UNIT-Electronics-MX/unit_devlab_i2s_ics_43434_mems_microphone/README.md

# DevLab: I2S ICS-43434 MEMS Microphone

The DevLab I2S ICS-43434 MEMS Microphone is a compact digital-audio module for
voice capture, acoustic sensing, and embedded audio prototypes. Its bottom-port
ICS-43434 microphone integrates signal conditioning, a 24-bit ADC, decimation
and anti-aliasing filters, power management, and an I²S interface.

<div align="center">
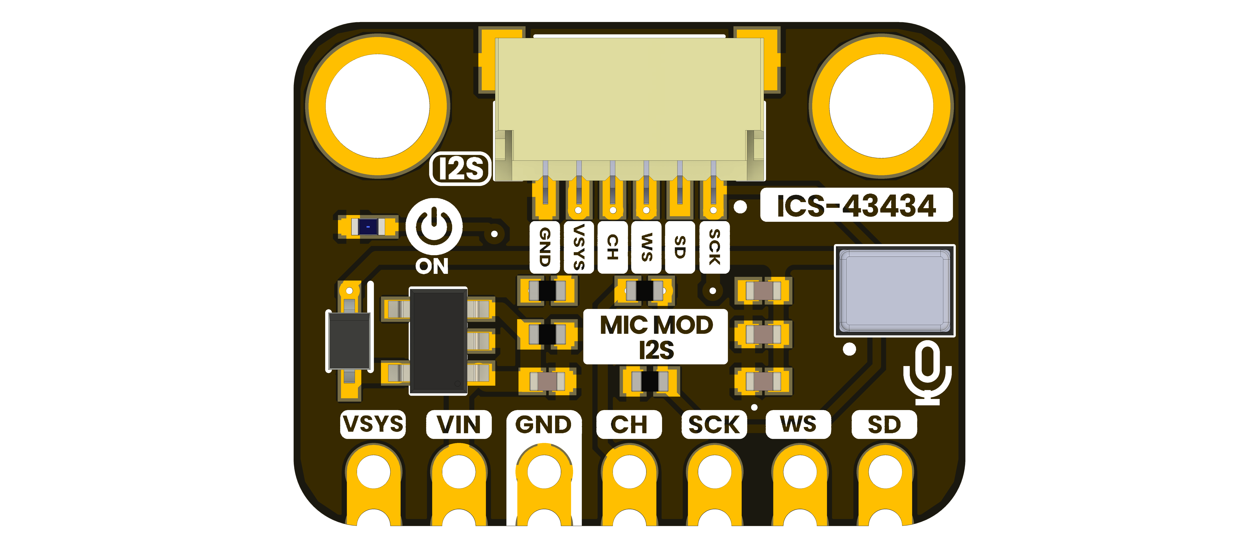
[picture p1: hardware/resources/unit_top_v_1_1_0_ue0149_devlab_i2s_ics_43434_mems_microphone_3d.png]
DevLab I2S ICS-43434 MEMS Microphone
  
  <p><em>DevLab I2S ICS-43434 MEMS Microphone</em></p>
</div>

<div align="center">

### Quick Setup

[]()
[](docs/hardware/unit_product_reference_v_0_1_0_i2s_ics43434_mems_microphone.pdf)
[]()
[](software/examples/i2s/README.md)

</div>

<div align="center">

## Overview

| Feature | Description |
|---|---|
| Product | DevLab I2S ICS-43434 MEMS Microphone |
| MPN | UE0149 |
| Microphone | InvenSense ICS-43434 bottom-port MEMS microphone |
| Module Input Voltage | Pending board-level validation; sensor VDD is 1.65–3.63 V |
| Sleep Mode Current | 12 uA |
| Sensitivity | -26 dB FS |
| Directionality | Omni |
| SNR | 64 dBA |
| Dynamic Range| 90 dB |
| Frequency Response | 60 Hz - 20 KHz |
| PSR | -98 dB FS |
| THD | 0.2 % |
| Hardware Revision | V1.0 |
| Audio Interface | I²S digital output |
| Sample Width | 24 bit |
| Channel Selection | `CH` input and `L/R` solder selection |
| Microphone Supply | 1.65 V to 3.63 V at the ICS-43434 VDD pin |
| Onboard Regulation | AP2112K fixed 3.3 V LDO |
| Connections | Seven 2.54 mm edge connections and 6-pin JST-SH connector |

</div>

## Applications

- **Voice Capture:** Digital audio acquisition for speech and voice interfaces.
- **Acoustic Sensing:** Sound-level and event-detection prototypes.
- **Communication:** Intercom and teleconferencing experiments.
- **Microphone Arrays:** Left/right channel selection for multi-microphone tests.
- **Education:** I²S audio acquisition and embedded-systems learning.

## Resources

- [Schematic Diagram](<hardware/unit_sch_v_1_1_0_ue0149_devlab_ i2s_ics_43434_mems_microphone.pdf>)
- [Pinout Diagram](https://github.com/UNIT-Electronics-MX/unit_devlab_i2s_ics_43434_mems_microphone/blob/main/hardware/README.md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)
- [Arduino library example](software/examples/i2s/cpp_examples/AudioInputBasicRead/AudioInputBasicRead.ino)
- [Software example instructions](software/examples/README.md)
- [Legacy I²S driver example](software/examples/i2s/cpp_examples/LegacySerialPlotter/LegacySerialPlotter.ino)

## 📝 License

All hardware and documentation in this project are licensed under the **MIT
License**. See the [repository license](https://github.com/UNIT-Electronics-MX/unit_devlab_i2s_ics_43434_mems_microphone/blob/main/LICENSE)
for details. Third-party reference files may have separate terms.
