UNIT-Electronics-MX/unit_devlab_i2s_ics_43434_mems_microphone/hardware/README.md

# DevLab I2S ICS-43434 MEMS Microphone Hardware

## Hardware Scope

This page documents **DevLab I2S ICS-43434 MEMS Microphone** from the V1.1.0 board views, pinout, schematic, and available component records. Component ratings do not define the complete module input limits.

| Field | Value |
|---|---|
| MPN | UE0149 |

## Power Tree

The BOM identifies `U3` as an AP2112K fixed 3.3 V regulator in the microphone power section. The permitted module-level `VIN` and `VSYS` ranges require board validation; a dedicated power-tree drawing is not available.

## Block Diagram

UE0149 I²S ICS-43434 functional block diagram

The host supplies `SCK` and `WS`; the microphone sends audio on
`SD`. The diagram also shows channel control and the board power section.

## Naming Rules

- Product name: **DevLab I2S ICS-43434 MEMS Microphone**.
- Product family: **UNIT DevLab ecosystem**.
- Existing source files retain their published names and revisions.
- Generated Product Reference: `unit_product_reference_v_0_1_0_i2s_ics43434_mems_microphone.pdf`.

## Hardware

The DevLab I2S ICS-43434 MEMS Microphone is a compact digital-audio module
based on the bottom-port ICS-43434 microphone. The board views correspond to
hardware V1.0.

<div align="center">
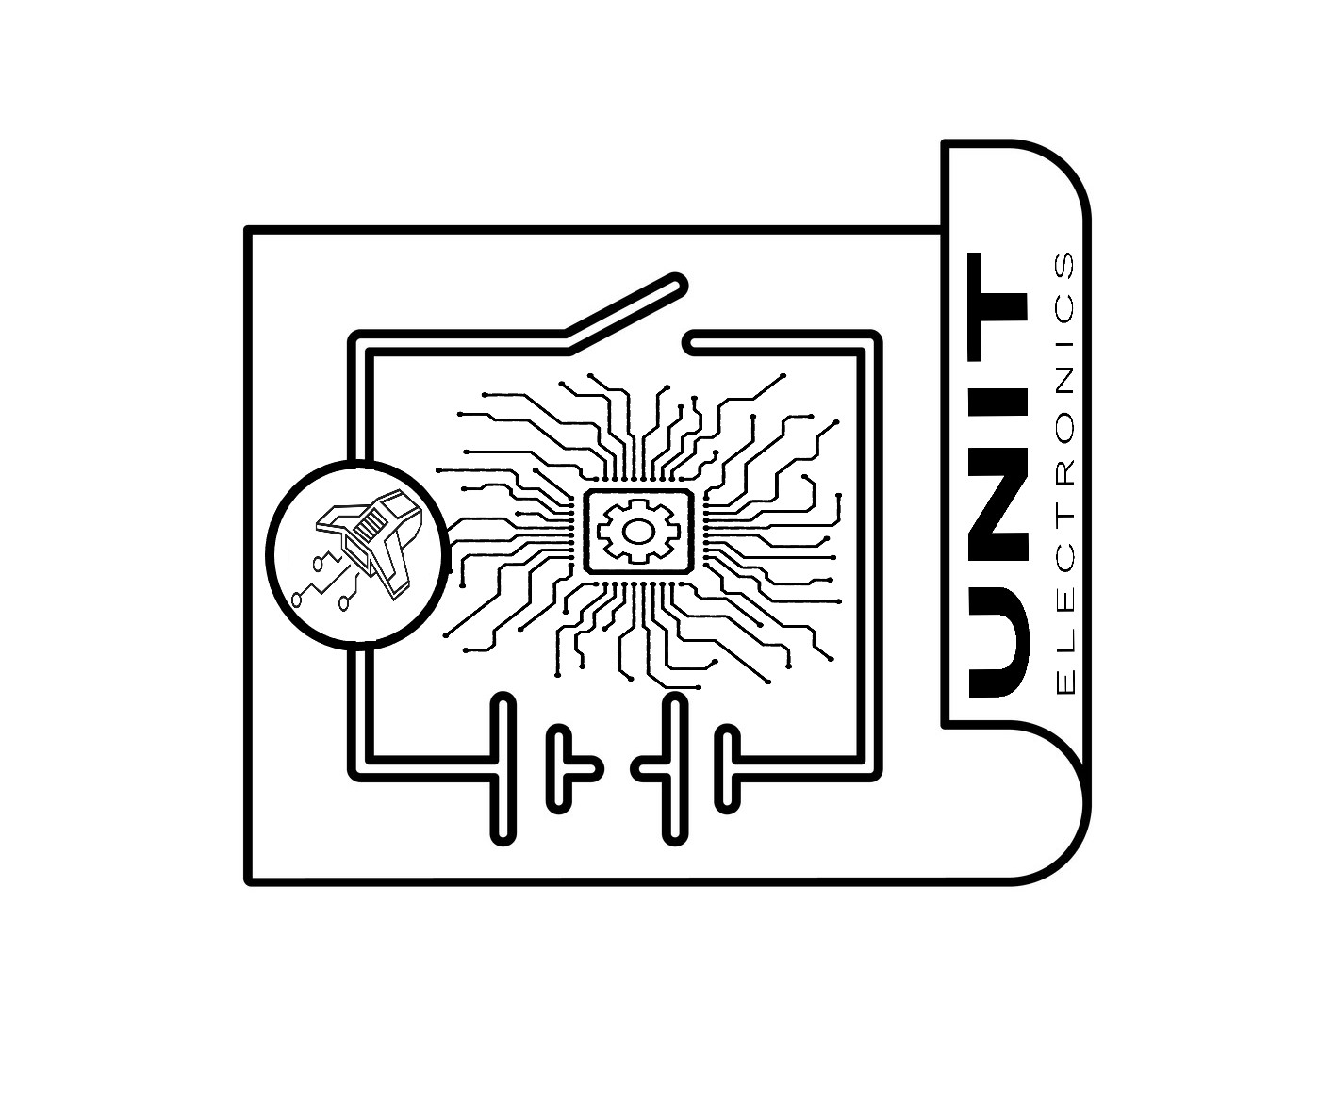
[picture p2: hardware/resources/Schematics_icon.jpg]
Schematic
<br/>
<a href="./unit_sch_v_1_1_0_ue0149_devlab_ i2s_ics_43434_mems_microphone.pdf">Schematic</a>
</div>

UE0149 I2S ICS-43434 top view

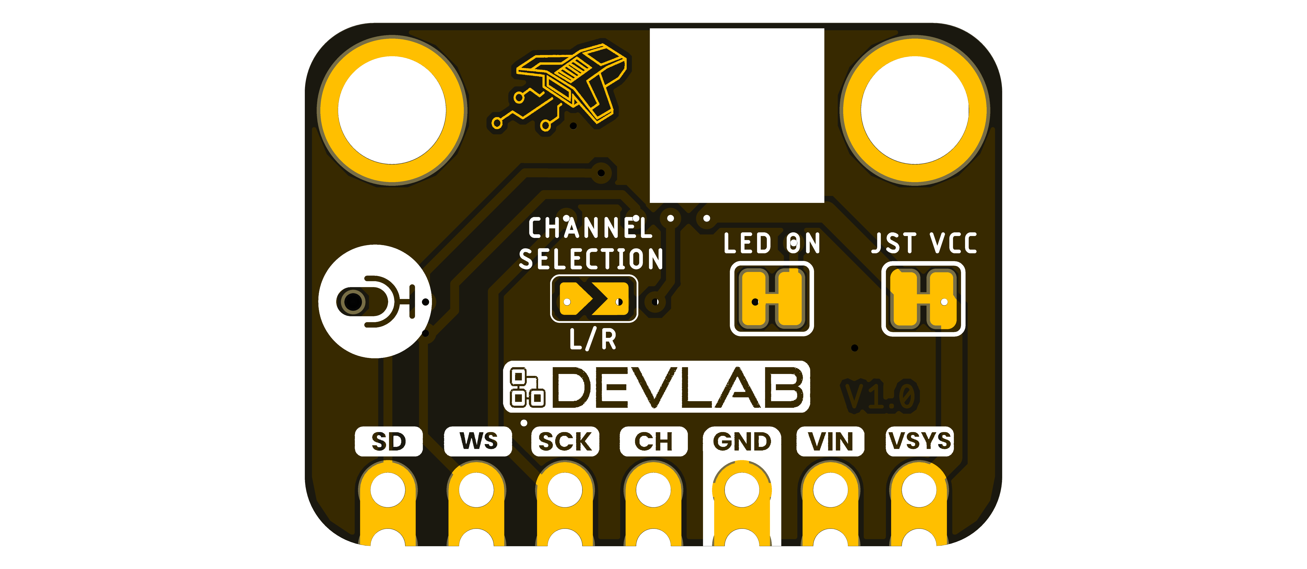
[picture p3: hardware/resources/unit_btm_v_1_1_0_ue0149_devlab_i2s_ics_43434_mems_microphone_3d.png]
UE0149 I2S ICS-43434 bottom view


## Pinout

<div align="center">
<a href="./unit_pinout_v_1_1_0_ue0149_devlab_ i2s_ics_43434_mems_microphone_en.pdf">
<br/>
Pinout
</a>
</div>

| Pin Label | Direction | Function | Notes |
|---|---|---|---|
| `VIN` | Input | Module input supply | Module-level range pending validation |
| `VSYS` | Power | Module system rail | 3.3 V |
| `GND` | Power | Common reference | 0 V |
| `CH` | Input | I²S channel selection | Low selects left; high selects right; schematic default is left |
| `SCK` | Input | I²S serial bit clock | Driven by the host |
| `WS` | Input | I²S word select | Low is left word; high is right word |
| `SD` | Output | I²S serial audio data | 24-bit microphone output |

## Dimensions

<div align="center">
<a href="./resources/unit_dimensions_v_1_1_0_ue0149_devlab_ i2s_ics_43434_mems_microphone.png">
<br/>
Dimensions
</a>
</div>

## Topology

<div align="center">
<a href="./resources/unit_topology_v_1_1_0_ue0149_devlab_ i2s_ics_43434_mems_microphone.png">
<br/>
Topology
</a>
</div>

| Ref. | Description |
|---|---|
| MK1 | ICS-43434 bottom-port digital MEMS microphone |
| U3 | AP2112K-3.3 fixed 3.3 V LDO regulator |
| D1 | Orange power indicator LED |
| D2 | NSR0320MW2T1G Schottky diode |
| J1 | 6-position JST-SH connector, 1.0 mm pitch |
| U$1 | Seven 2.54 mm edge connections |
| `L/R` | Channel-selection solder option |
| `LED ON` | Indicator solder option; behavior pending schematic verification |
| `JST VCC` | Connector-supply solder option; behavior pending schematic verification |

## Pin & Connector Layout

The seven edge connections expose `VSYS`, `VIN`, `GND`, `CH`, `SCK`, `WS`, and
`SD`. The six-position JST-SH connector exposes `GND`, `VSYS`, `CH`, `WS`, `SD`,
and `SCK`; `VIN` is available only on the edge connection.

| Signal | Electrical Information | Function |
|---|---|---|
| `VIN` | Module range pending | Input to the onboard power section |
| `VSYS` | Range pending | System and JST supply rail |
| `GND` | 0 V | Common power and signal reference |
| `CH` | Logic level pending module validation | Selects the I²S left or right time slot |
| `SCK` | Logic level pending module validation | Serial bit clock from the host |
| `WS` | Logic level pending module validation | Word-select clock from the host |
| `SD` | Digital output | Serial audio data to the host |

> **Note:** The BOM lists a four-conductor QWIIC-style harness while J1 is a
> six-position connector. Cable inclusion and compatibility must be verified
> before connection.

## Functional Description

The host supplies the I²S clocks on `SCK` and `WS`. The ICS-43434 converts the
acoustic signal and transmits 24-bit samples on `SD` in the time slot selected
by `CH`. The AP2112K provides a nominal 3.3 V rail for the microphone circuit.

Keep the bottom acoustic port unobstructed and free of debris, adhesive, flux,
or enclosure pressure. Connect the host and module grounds before applying
power or clocks. Do not drive `SD`; it is an output from the microphone.

### Electrical Characteristics

| Parameter | Value | Scope |
|---|---:|---|
| Microphone VDD | 1.65 V to 3.63 V | ICS-43434 supply pin, DS-000069 rev. 1.2 |
| Digital output | 24 bit | ICS-43434 I²S interface |
| Signal-to-noise ratio | 65 dBA high-performance; 64 dBA low-power, typical | Microphone characteristic |
| Frequency response | 60 Hz to 20 kHz | EMMIC-ICS43434 reference |
| Sensitivity tolerance | ±1 dB | Microphone characteristic |

The microphone VDD range and individual component ratings do not establish the
permitted voltage at the module's `VIN` pin.

### BOM-Confirmed Components

| Reference | Identification |
|---|---|
| MK1 | ICS-43434 |
| U3 | AP2112K-3.3TRG1 |
| J1 | JST SM06B-SRSS-TB |
| D2 | NSR0320MW2T1G |
| C8, C9 | 1 µF, 6.3 V, X5R, 0402 |
| C6 | 100 nF, 0402 |
| C1 | 200 pF, C0G, 50 V, 0402 |
| R1 | 4.7 kΩ, 0402 |
| R2, R3 | 10 kΩ, 0402 |
| R5 | 0 Ω, 0402 |

## Applications

- Voice capture and recognition prototypes
- Acoustic sensing and sound-event detection
- Intercom and teleconferencing systems
- Stereo and multi-microphone experiments
- Educational I²S audio acquisition

## References

- [EMMIC-ICS43434 Reference](https://github.com/UNIT-Electronics-MX/unit_devlab_i2s_ics_43434_mems_microphone/blob/main/hardware/resources/external/emmic-ics43434-ds.pdf)
- [Manufacturer ICS-43434 datasheet](resources/external/DS-000069-ICS-43434-v1.2.pdf)
- [DevLab_AudioInput example](../software/examples/i2s/cpp_examples/AudioInputBasicRead/AudioInputBasicRead.ino)
- [Manufacturing BOM](https://github.com/UNIT-Electronics-MX/unit_devlab_i2s_ics_43434_mems_microphone/blob/main/hardware/resources/UNIT-0149%20Devlab_%20I2S%20ICS-43434%20MEMS%20Micropho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)
- [Legacy I²S Example](https://github.com/UNIT-Electronics-MX/unit_devlab_i2s_ics_43434_mems_microphone/blob/main/software/examples/i2s/cpp_examples/LegacySerialPlotter/LegacySerialPlotter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)
- [Product Reference](../docs/hardware/unit_product_reference_v_0_1_0_i2s_ics43434_mems_microphone.pdf)
