UNIT-Electronics-MX/unit_devlab_i2s_ics_43434_mems_microphone/software/README.md

# UE0149 Software

See [Software Examples](examples/README.md) for the ESP32-S3
`DevLab_AudioInput` sketch, channel selection, and wiring notes.
The complete board procedure is in
[Board Operation](../tools/product-reference/chapters/05-board-operation.md).
