UNIT-Electronics-MX/unit_devlab_i2s_ics_43434_mems_microphone/tools/product-reference/chapters/06-mechanical.md

## **6 Mechanical Information**

### **6.1 Top View** {.section-page}

UE0149 I2S microphone top view.

### **6.2 Bottom View** {.section-page}

UE0149 I2S microphone bottom view.

The bottom acoustic port remains clear of adhesive, contamination, and mounting hardware.

### **6.3 Board Dimensions** {.section-page}

The [dimension drawing](https://github.com/UNIT-Electronics-MX/unit_devlab_i2s_ics_43434_mems_microphone/blob/main/hardware/resources/unit_dimensions_v_1_1_0_ue0149_devlab_%20i2s_ics_43434_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)
is stored with the board images.

The labeled drawing provides the board dimensions for mechanical layout.
The physical assembly determines connector clearance and manufacturing tolerances.
