UNIT-Electronics-MX/unit_devlab_i2s_ics_43434_mems_microphone/tools/product-reference/chapters/01-board.md

## **1 The Module**

### **1.1 Board Identification**

| Item | Value |
|---|---|
| Product | DevLab: I2S ICS-43434 MEMS Microphone |
| Manufacturer part number | UE0149 |
| Hardware revision shown | V1.0 |
| Microphone | ICS-43434 |
| Digital audio interface | I²S |
| Product-reference revision | 0.1.0 |

### **1.2 Interface Hardware**

The module provides seven 2.54 mm edge connections and a six-position,
1.0 mm-pitch JST-SH connector. The connector carries `GND`, `VSYS`, `CH`,
`WS`, `SD`, and `SCK`. Its signal order follows the board pinout in Section 4.
