UNIT-Electronics-MX/unit_devlab_i2s_ics_43434_mems_microphone/tools/product-reference/chapters/08-references.md

## **8 Reference Documentation**

| Reference | Location |
|---|---|
| Repository | [UNIT-Electronics-MX/unit_devlab_i2s_ics_43434_mems_microphone](https://github.com/UNIT-Electronics-MX/unit_devlab_i2s_ics_43434_mems_microphone) |
| Hardware notes | [Hardware README](https://github.com/UNIT-Electronics-MX/unit_devlab_i2s_ics_43434_mems_microphone/blob/main/hardware/README.md) |
| Pinout PDFs | [English](https://github.com/UNIT-Electronics-MX/unit_devlab_i2s_ics_43434_mems_microphone/blob/main/hardware/unit_pinout_v_1_1_0_ue0149_devlab_%20i2s_ics_43434_mems_microphon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) · [Spanish](https://github.com/UNIT-Electronics-MX/unit_devlab_i2s_ics_43434_mems_microphone/blob/main/hardware/unit_pinout_v_1_1_0_ue0149_devlab_%20i2s_ics_43434_mems_microphon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) |
| Pinout images | [English PNG](https://github.com/UNIT-Electronics-MX/unit_devlab_i2s_ics_43434_mems_microphone/blob/main/hardware/resources/unit_pinout_v_1_1_0_ue0149_devlab_%20i2s_ics_43434_mems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) · [Spanish PNG](https://github.com/UNIT-Electronics-MX/unit_devlab_i2s_ics_43434_mems_microphone/blob/main/hardware/resources/unit_pinout_v_1_1_0_ue0149_devlab_%20i2s_ics_43434_mems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) |
| Microphone reference | [EMMIC-ICS43434 PDF](https://github.com/UNIT-Electronics-MX/unit_devlab_i2s_ics_43434_mems_microphone/blob/main/hardware/resources/external/emmic-ics43434-ds.pdf) |
| Manufacturer sensor datasheet | [DS-000069 rev. 1.2](https://github.com/UNIT-Electronics-MX/unit_devlab_i2s_ics_43434_mems_microphone/blob/main/hardware/resources/external/DS-000069-ICS-43434-v1.2.pdf) |
| Module schematic | [UE0149 schematic](https://github.com/UNIT-Electronics-MX/unit_devlab_i2s_ics_43434_mems_microphone/blob/main/hardware/unit_sch_v_1_1_0_ue0149_devlab_%20i2s_ics_43434_mems_microphone.p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) |
| Capture library | [DevLab_AudioInput](https://github.com/UNIT-Electronics-MX/unit_devlab_audioinput_library) |
| Module block diagram | [UE0149 block diagram](https://github.com/UNIT-Electronics-MX/unit_devlab_i2s_ics_43434_mems_microphone/blob/main/hardware/resources/external/i2s_ics_43434_mems_microphone.png) |
| Library-based example | [UE0149 AudioInputBasicRead](https://github.com/UNIT-Electronics-MX/unit_devlab_i2s_ics_43434_mems_microphone/blob/main/software/examples/i2s/cpp_examples/AudioInputBasicRead/AudioInputBasicRead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) |
| Experimental firmware | [Legacy I²S example](https://github.com/UNIT-Electronics-MX/unit_devlab_i2s_ics_43434_mems_microphone/blob/main/software/examples/i2s/cpp_examples/LegacySerialPlotter/LegacySerialPlotter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) |
| Top view | [3D board view](https://github.com/UNIT-Electronics-MX/unit_devlab_i2s_ics_43434_mems_microphone/blob/main/hardware/resources/unit_top_v_1_1_0_ue0149_devlab_i2s_ics_43434_mems_micro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) |
| Bottom view | [3D board view](https://github.com/UNIT-Electronics-MX/unit_devlab_i2s_ics_43434_mems_microphone/blob/main/hardware/resources/unit_btm_v_1_1_0_ue0149_devlab_i2s_ics_43434_mems_micro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) |
| CAD model | [STEP](https://github.com/UNIT-Electronics-MX/unit_devlab_i2s_ics_43434_mems_microphone/blob/main/hardware/mechanics/unit_3d_v_1_1_0_ue0149_devlab_%20i2s_ics_43434_mems_mic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) |

The manufacturer document DS-000069 revision 1.2 (2016-08-29) supplies the
sensor timing, modes, and interface characteristics. The UE0149 schematic
supplies the module circuit connections, and the board artwork supplies the
visible signal labels. The EMMIC-ICS43434 file describes a separate
breakout board.
