UNIT-Electronics-MX/unit_devlab_i2s_ics_43434_mems_microphone/tools/product-reference/chapters/00-description.md

## **Description**

The UNIT DevLab I²S ICS-43434 MEMS Microphone is a compact digital-audio module based on the
bottom-port ICS-43434 MEMS microphone. The microphone integrates signal
conditioning, a 24-bit analog-to-digital converter, decimation and
anti-aliasing filters, power management, and an I²S output.



### **Applications**

- Voice capture and recognition prototypes
- Intercom and teleconferencing systems
- Acoustic sensing and security projects
- Stereo or microphone-array experiments
- Educational I²S audio acquisition

### **Hardware Features**

- ICS-43434 bottom-port digital MEMS microphone
- 24-bit I²S serial audio output
- Left/right time-slot selection through the `CH` signal
- AP2112K fixed 3.3 V onboard regulator
- Seven 2.54 mm edge connections
- Six-position, 1.0 mm-pitch JST-SH connector
- Power indicator and selectable solder options shown on the V1.0 artwork
