UNIT-Electronics-MX/unit_devlab_i2s_ics_43434_mems_microphone/docs/hardware/index.html

UNIT Electronics · DevLab

# DevLab I2S ICS-43434 MEMS Microphone

Direct links to hardware documentation and product files for use in external platforms.

22 files 11 images 8 formats 44.1 MB total

Search hardware resources

## Product documents

3 files

DOCX 3.7 MB

### Product Reference

Editable product reference

unit_product_reference_v_0_1_0_i2s_ics43434_mems_microphone.docx

Copy link Open file

PDF 4.1 MB

### Product Reference

Publication-ready product reference

unit_product_reference_v_0_1_0_i2s_ics43434_mems_microphone.pdf

Copy link Open file

PDF 49.8 KB

### Schematic

Electrical schematic

unit_sch_v_1_1_0_ue0149_devlab_ i2s_ics_43434_mems_microphone.pdf

Copy link Open file

## Pinouts

6 files

JPG 6.5 MB

### Pinout — English

Connector and signal reference in English

resources/unit_pinout_v_1_1_0_ue0149_devlab_ i2s_ics_43434_mems_microphone_en.jpg

Copy link Open file

PDF 5.2 MB

### Pinout — English

Connector and signal reference in English

unit_pinout_v_1_1_0_ue0149_devlab_ i2s_ics_43434_mems_microphone_en.pdf

Copy link Open file

PNG 1.8 MB

### Pinout — English

Connector and signal reference in English

resources/unit_pinout_v_1_1_0_ue0149_devlab_ i2s_ics_43434_mems_microphone_en.png

Copy link Open file

JPG 6.6 MB

### Pinout — Spanish

Connector and signal reference in Spanish

resources/unit_pinout_v_1_1_0_ue0149_devlab_ i2s_ics_43434_mems_microphone_es.jpg

Copy link Open file

PDF 5.2 MB

### Pinout — Spanish

Connector and signal reference in Spanish

unit_pinout_v_1_1_0_ue0149_devlab_ i2s_ics_43434_mems_microphone_es.pdf

Copy link Open file

PNG 1.8 MB

### Pinout — Spanish

Connector and signal reference in Spanish

resources/unit_pinout_v_1_1_0_ue0149_devlab_ i2s_ics_43434_mems_microphone_es.png

Copy link Open file

## Board views

5 files

PNG 1.1 MB

### Board Topology

Functional board layout

resources/unit_topology_v_1_1_0_ue0149_devlab_ i2s_ics_43434_mems_microphone.png

Copy link Open file

PNG 1.0 MB

### Bottom View

Bottom-side board view

resources/unit_btm_v_1_1_0_ue0149_devlab_i2s_ics_43434_mems_microphone_3d.png

Copy link Open file

PNG 816.2 KB

### Mechanical Dimensions

Board outline and dimensions

resources/unit_dimensions_v_1_1_0_ue0149_devlab_ i2s_ics_43434_mems_microphone.png

Copy link Open file

PNG 1.1 MB

### Top View

Top-side board view

resources/unit_top_v_1_0_0_i2s_ics43434_mems_microphone.png

Copy link Open file

PNG 1018.2 KB

### Top View

Top-side board view

resources/unit_top_v_1_1_0_ue0149_devlab_i2s_ics_43434_mems_microphone_3d.png

Copy link Open file

## CAD and design files

1 file

STEP 1.1 MB

### 3D CAD Model

STEP mechanical model

mechanics/unit_3d_v_1_1_0_ue0149_devlab_ i2s_ics_43434_mems_microphone.step

Copy link Open file

## Other resources

7 files

FILE 41 B

### .Gitattributes

Hardware resource

mechanics/.gitattributes

Copy link Open file

PNG 32.3 KB

### Audioinput Library

Hardware resource

resources/external/audioinput_library.png

Copy link Open file

PDF 1.1 MB

### Ds 000069 Ics 43434 V1.2

Hardware resource

resources/external/DS-000069-ICS-43434-v1.2.pdf

Copy link Open file

PDF 633.4 KB

### Emmic Ics43434 Ds

Hardware resource

resources/external/emmic-ics43434-ds.pdf

Copy link Open file

MD 7.0 KB

### Hardware README

Hardware overview and source notes

README.md

Copy link Open file

PNG 145.8 KB

### I2S Ics 43434 Mems Microphone

Hardware resource

resources/external/i2s_ics_43434_mems_microphone.png

Copy link Open file

F3D 1.4 MB

### Unit 3D V 1 1 0 Ue0149 Devlab I2S Ics 43434 Mems Microphone

Hardware resource

mechanics/unit_3d_v_1_1_0_ue0149_devlab_ i2s_ics_43434_mems_microphone.f3d

Copy link Open file

No resources match your search.

UNIT Electronics hardware resources
