UNIT-Electronics-MX/unit_devlab_i2s_ics_43434_mems_microphone/hardware/resources/unit_btm_v_1_1_0_ue0149_devlab_ i2s_ics_43434_mems_microphone_2d.png

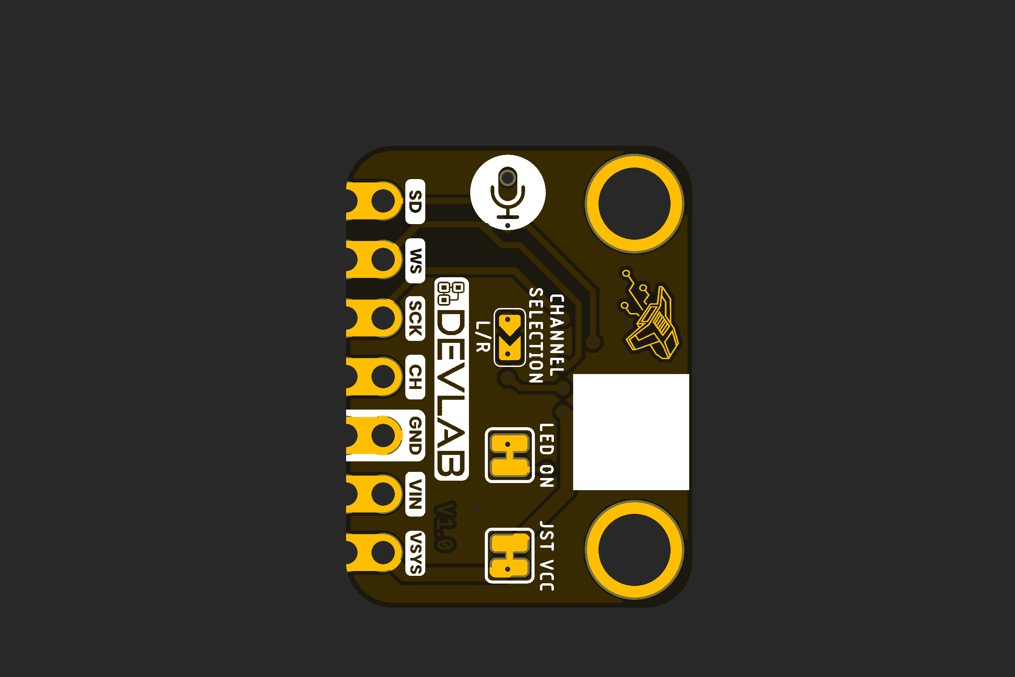
hardware/resources/unit_btm_v_1_1_0_ue0149_devlab_ i2s_ics_43434_mems_microphone_2d.png
