UNIT-Electronics-MX/unit_devlab_i2s_ics_43434_mems_microphone/hardware/mechanics/unit_3d_v_1_1_0_ue0149_devlab_ i2s_ics_43434_mems_microphone.step

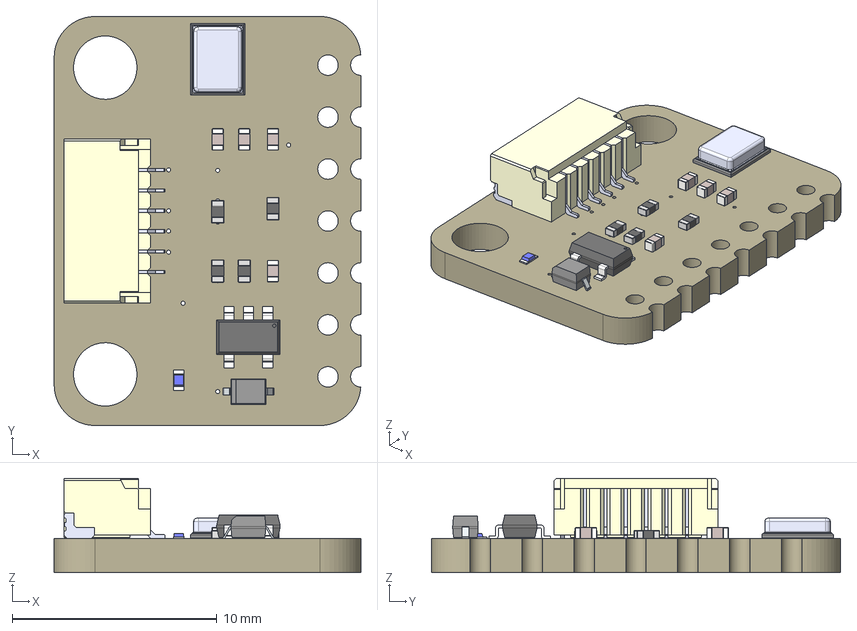
[picture p9: CAD file, 2026-11-02]
hardware/mechanics/unit_3d_v_1_1_0_ue0149_devlab_ i2s_ics_43434_mems_microphone.step
15.0 x 20.0 x 4.61 mm
