UNIT-Electronics-MX/unit_devlab_i2s_ics_43434_mems_microphone/(list of files, cad)

Other CAD files:
hardware/mechanics/unit_3d_v_1_1_0_ue0149_devlab_ i2s_ics_43434_mems_microphone.f3d
