UNIT-Electronics-MX/unit_devlab_i2s_ics_43434_mems_microphone/docs/hardware/unit_pinout_v_1_1_0_ue0149_devlab_ i2s_ics_43434_mems_microphone_en.pdf

# PINOUT

# DevLab: I2S ICS-43434 MEMS Microphone

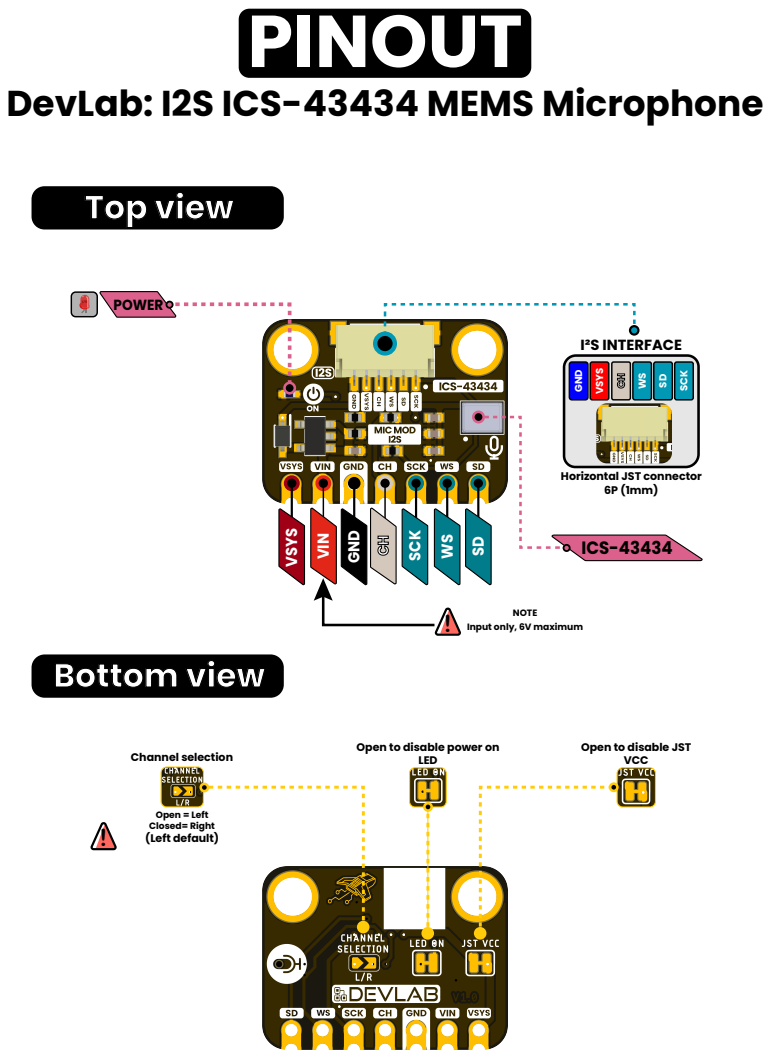
[picture p10: page 1]
Bottom view; Top view; Channel selection; POWER; VIN; SCK; VSYS; GND; ICS-43434; NOTE Input only, 6V maximum; LED; Horizontal JST connector 6P (1mm); I²S INTERFACE; Open = Left Closed= Right (Left default)

Open to disable power on

Open to disable JST
VCC
