UNIT-Electronics-MX/unit_devlab_i2s_ics_43434_mems_microphone/docs/hardware/unit_pinout_v_1_1_0_ue0149_devlab_ i2s_ics_43434_mems_microphone_es.pdf

# PINOUT

# DevLab: I2S ICS-43434 MEMS Microphone

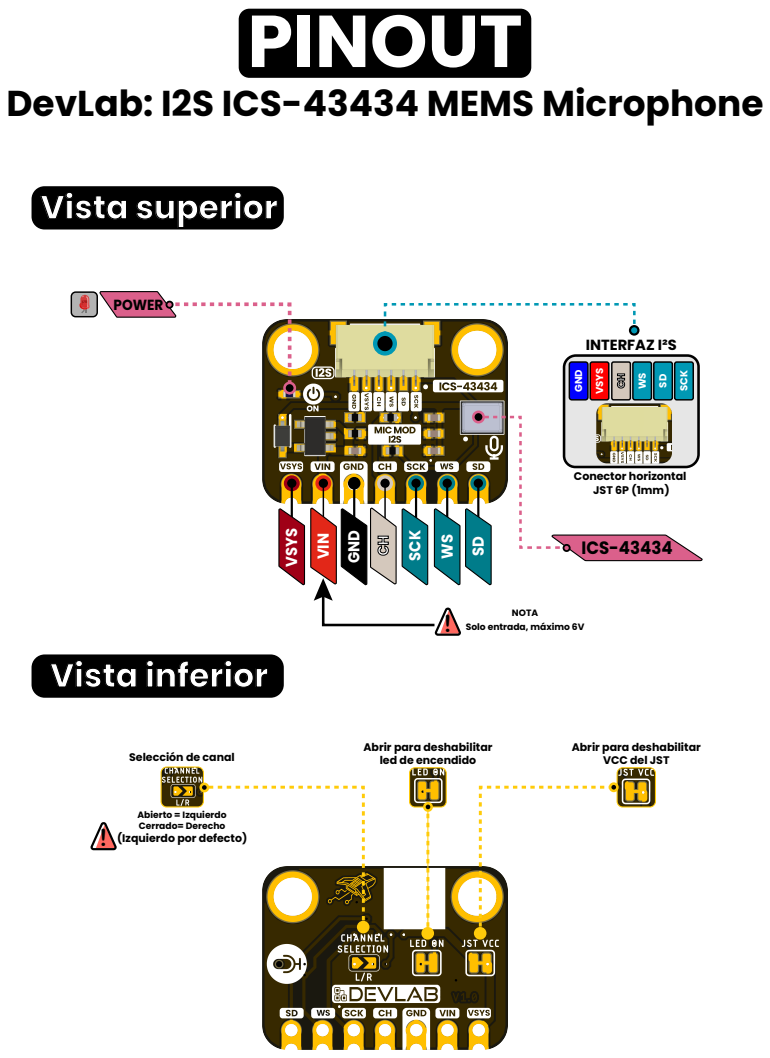
[picture p11: page 1]
Vista inferior; Vista superior; POWER; VIN; SCK; VSYS; GND; ICS-43434; NOTA Solo entrada, máximo 6V; Conector horizontal

INTERFAZ I²S
JST 6P (1mm) VSYS CHWS SD

Abrir para deshabilitar
led de encendido

VCC del JST

Selección de canal

Abierto = Izquierdo
Cerrado= Derecho
(Izquierdo por defecto)
