UNIT-Electronics-MX/unit_devlab_i2s_ics_43434_mems_microphone/docs/hardware/unit_sch_v_1_1_0_ue0149_devlab_ i2s_ics_43434_mems_microphone.pdf

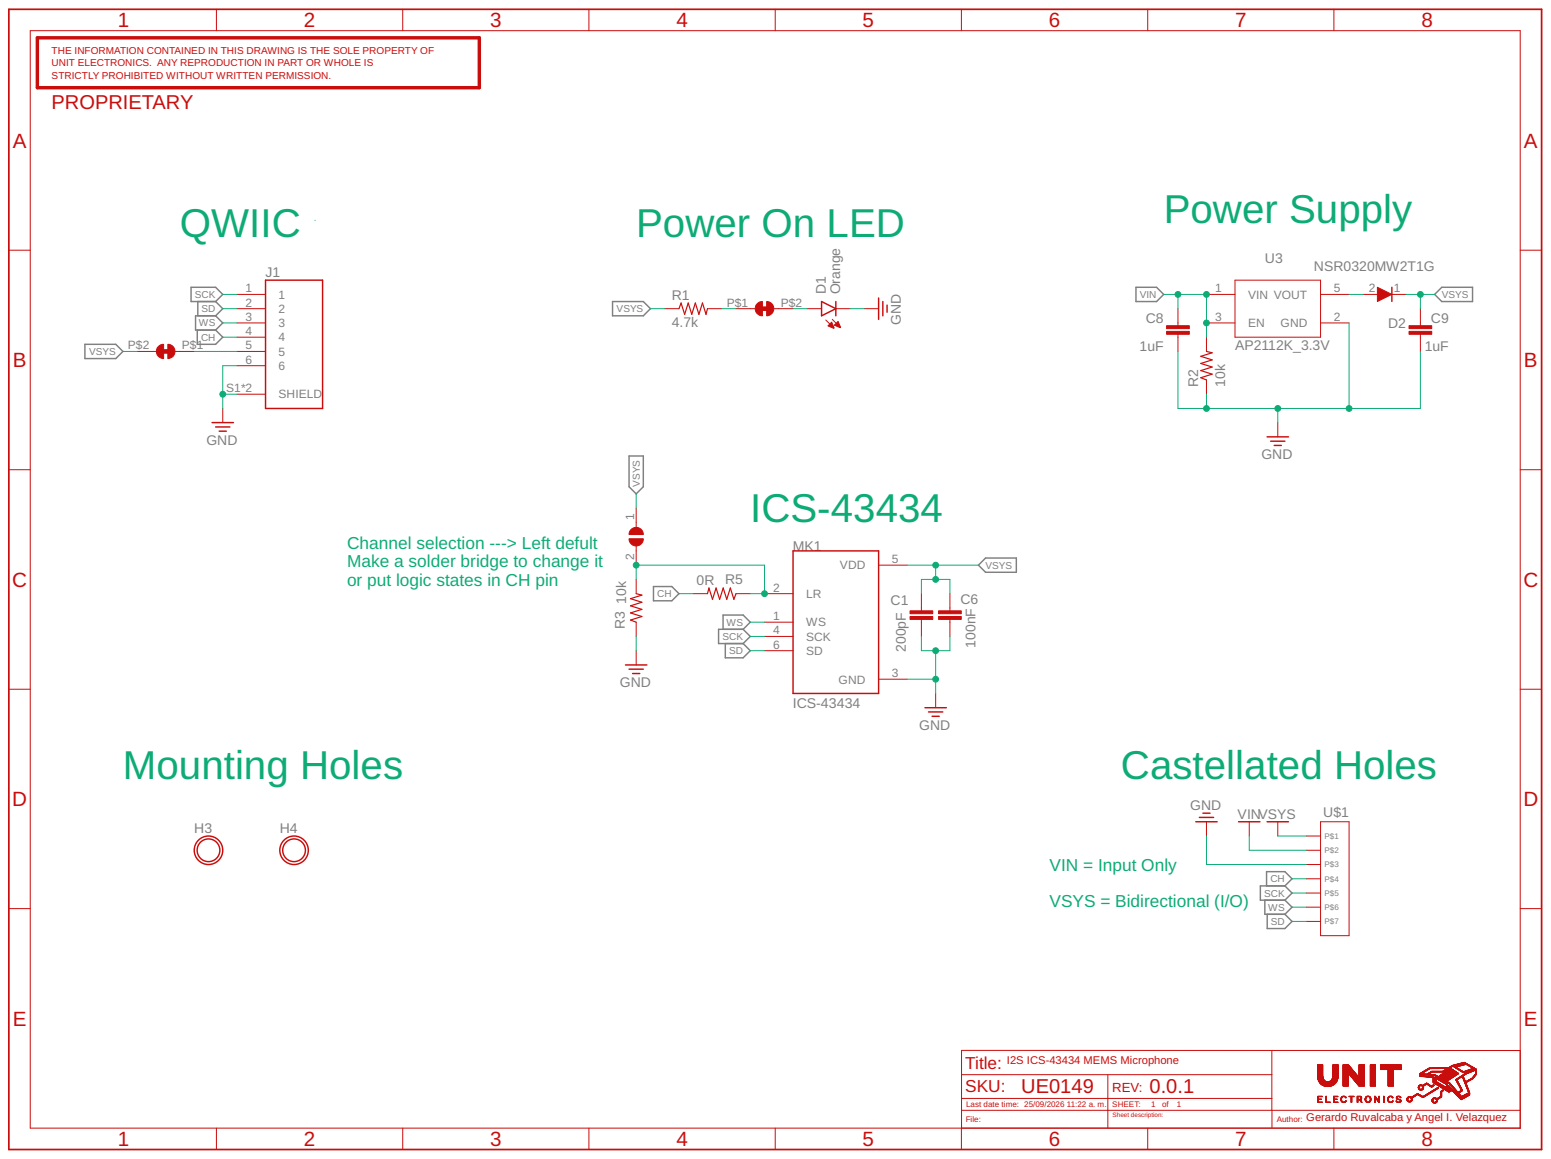
[picture p12: page 1]

THE INFORMATION CONTAINED IN THIS DRAWING IS THE SOLE PROPERTY OF UNIT ELECTRONICS. ANY REPRODUCTION IN PART OR WHOLE IS

STRICTLY PROHIBITED WITHOUT WRITTEN PERMISSION. PROPRIETARY

Channel selection ---> Left defult
Make a solder bridge to change it or put logic states in CH pin

Gerardo Ruvalcaba y Angel I. Velazquez
