UNIT-Electronics-MX/unit_devlab_i2s_ics_43434_mems_microphone/(commit log)

2026-08-03 docs: update board documentation
2026-08-05 docs(README): Schematic added
2026-11-02 Integrate product-specific board views and mechanical assets
2026-11-02 Remove unpopulated board layout views
2026-11-03 Embed pinout and schematic images in I2S product reference
2026-11-03 Place I2S pinout on its page and move schematic to appendix end
